fd0/rumpus/README.md

# rumpus

Hard- and Software for the rumpus Atmel AVR development platform.

Helpful links:
 * http://lochraster.org/rumpus
 * http://wiki.lochraster.org/wiki/Rumpus/Aufbauanleitung-v2.html
 * http://wiki.lochraster.org/wiki/Rumpus/Schnellstart.html
