fd0/rumpus/PCB/rumpus.brd

## EAGLE design PCB/rumpus.brd (2016-03-28)

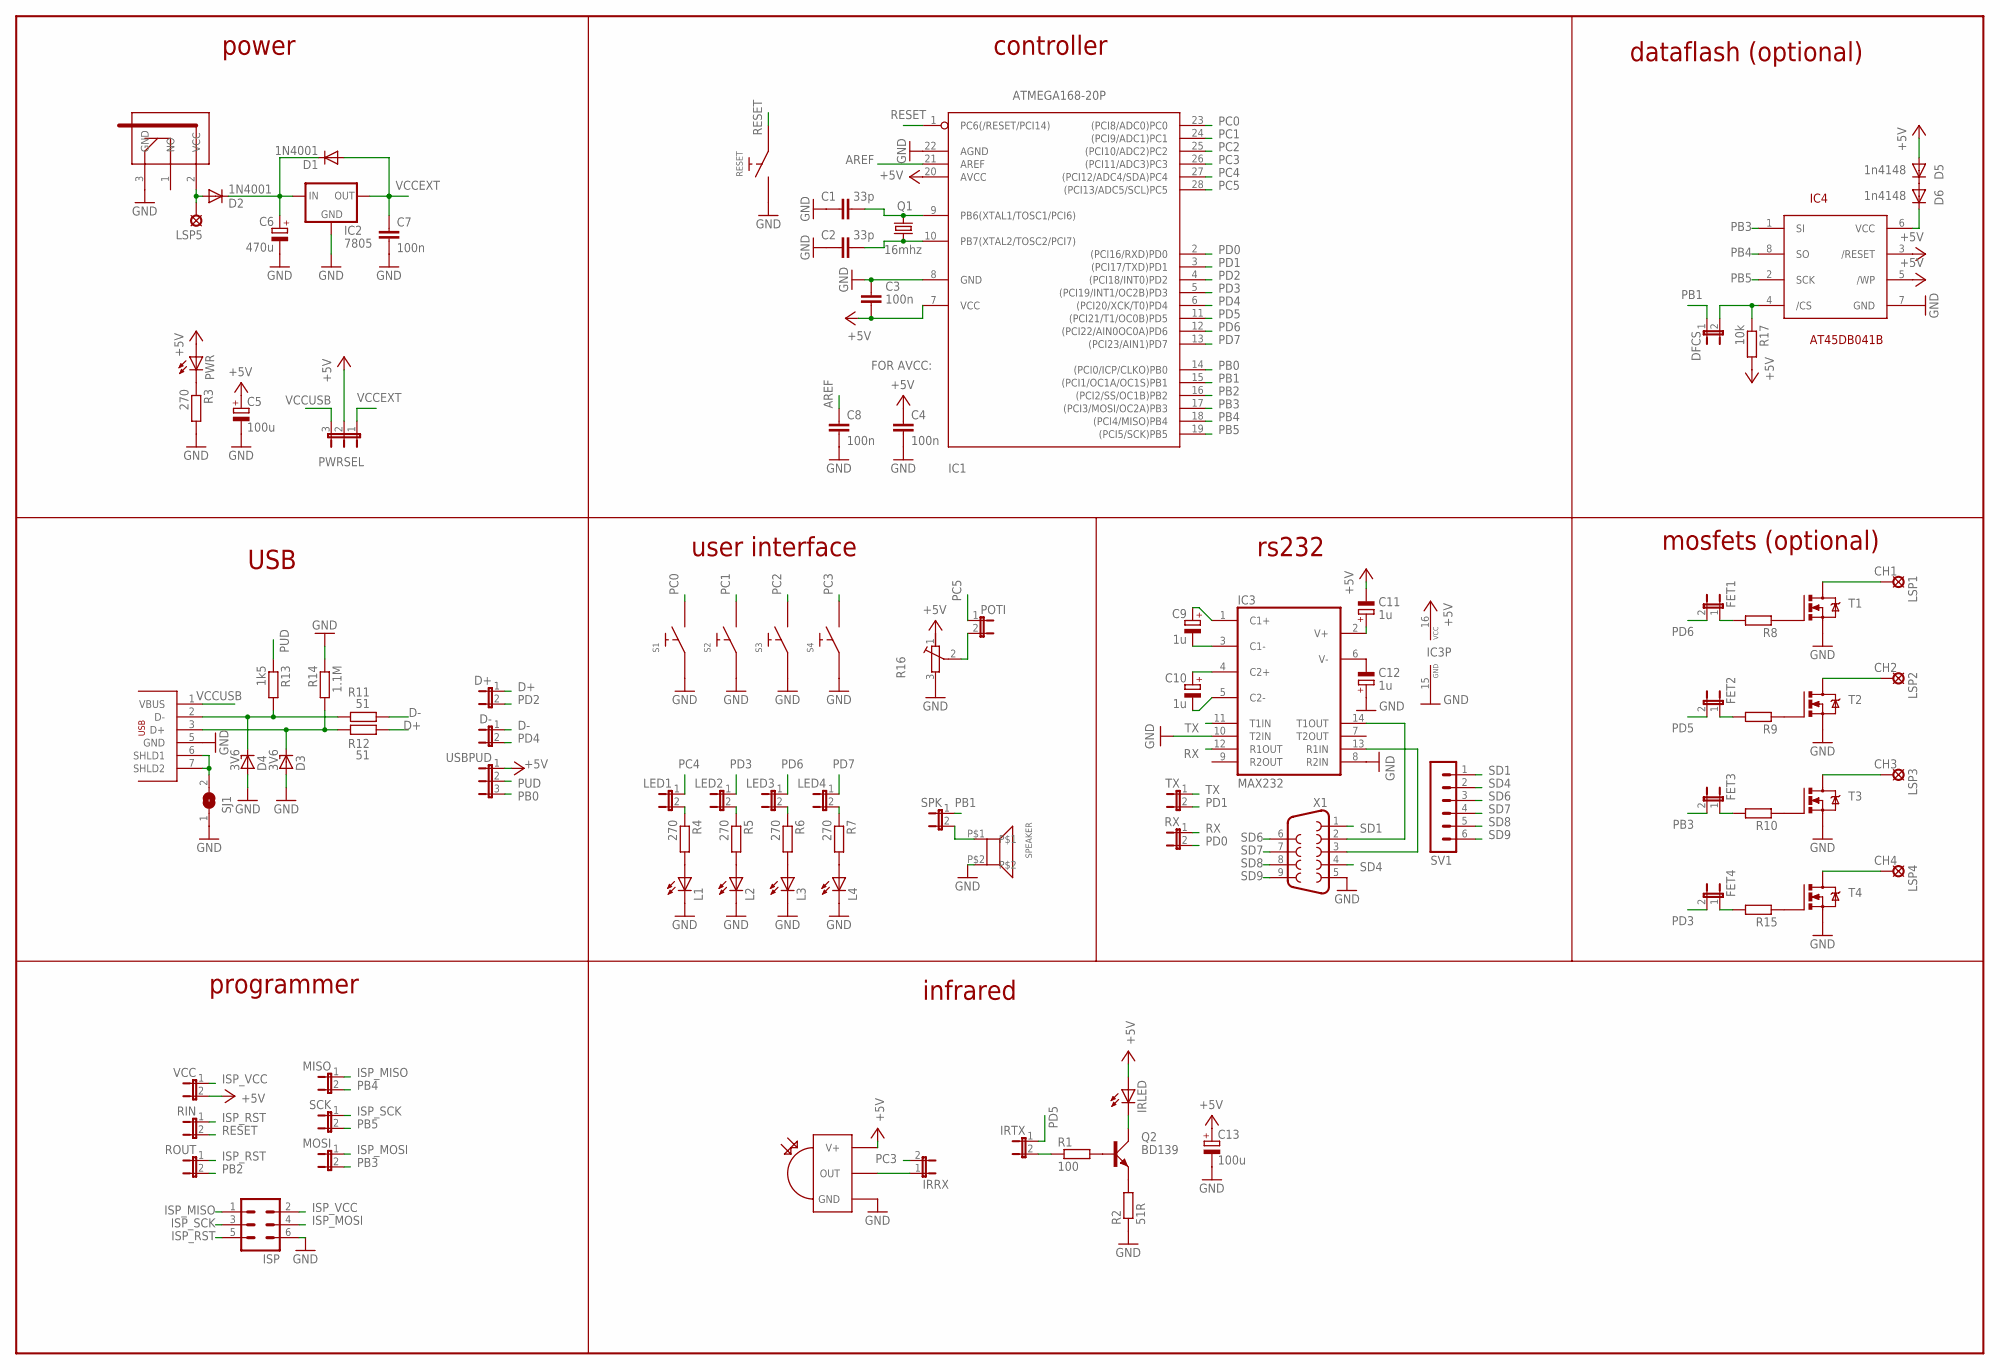
[picture p1: schematic rumpus.sch]

Parts:
C1, C2: 33p; C025-024X044
C3, C4, C7, C8: 100n; C025-024X044
C5, C13: 100u; E2,5-6
C6: 470u; E5-10,5
C9, C10, C11, C12: 1u; E2,5-6
D1, D2: 1N4001; DO41-10
D3, D4: 3V6; ZDIO-2.5
D5, D6: 1n4148; D-2.5
D+: JP1E; JP1
D-: JP1E; JP1
DFCS: JP1E; JP1
FET1, FET2, FET3, FET4: JP1E; JP1
IC1: ATMEGA168-20P; DIL28-3
IC2: 7805; 78XXS
IC3: MAX232; DIL16
IC4: AT45DB041B; SOIC8
IRLED: LED5MM
IRRX: JP1E; JP1
IRTX: JP1E; JP1
ISP: MA03-2
L1, L2, L3, L4: LED3MM
LED1, LED2, LED3, LED4: JP1E; JP1
LSP1, LSP2, LSP3, LSP4, LSP5: LSP10
MISO: JP1E; JP1
MOSI: JP1E; JP1
POTI: JP1E; JP1
PWR: LED3MM
PWRSEL: JP2E; JP2
Q1: 16mhz; HC49U-V
Q2: BD139; TO126AV
R1: 100; 0204V
R2: 51R; 0204V
R3: 270; 0204/7
R4, R5, R6, R7: 270; 0204V
R8, R9, R10, R15: R-EU_0204/2V; 0204V
R11, R12: 51; 0204V
R13: 1k5; 0204V
R14: 1.1M; 0204V
R16: R-TRIMMPT6-L; PT6-L
R17: 10k; 0204V
RESET: MIKROTASTER6X6L; TASTER3301
RIN: JP1E; JP1
ROUT: JP1E; JP1
RX: JP1E; JP1
S1, S2, S3, S4: MIKROTASTER6X6L; TASTER3301
SCK: JP1E; JP1
SJ1: SJ
SPEAKER: BUZZER
SPK: JP1E; JP1
SV1: MA06-1
T1, T2, T3, T4: N-CHANNEL-MOSFET; TO220BV
TX: JP1E; JP1
U$2: TSOP1738; TSOP17XX
U$3: HEBW21
USB: USB-SOCKETMINI-B; USB-BWM
USBPUD: JP2E; JP2
VCC: JP1E; JP1
X1: F09HP

Connections:
+5V: C3.2, C4.1, C5.+, C11.-, C13.+, D5.A, IC1.7 (VCC), IC1.20 (AVCC), IC3.16 (VCC), IC4.3 (/RESET), IC4.5 (/WP), IRLED.A, PWR.A, PWRSEL.2, R16.1 (A), R17.2, U$2.V+, USBPUD.1, VCC.2
AREF: C8.1, IC1.21 (AREF)
CH1: LSP1.MP, T1.D
CH2: LSP2.MP, T2.D
CH3: LSP3.MP, T3.D
CH4: LSP4.MP, T4.D
D+: D+.1, R12.2
D-: D-.1, R11.2
GND: C1.2, C2.2, C3.1, C4.2, C5.-, C6.-, C7.2, C8.2, C12.+, C13.-, D3.A, D4.A, IC1.8 (GND), IC1.22 (AGND), IC2.GND, IC3.8 (R2IN), IC3.10 (T2IN), IC3.15 (GND), IC4.7 (GND), ISP.6, L1.K (C), L2.K (C), L3.K (C), L4.K (C), R2.1, R3.2, R14.1, R16.3 (E), RESET.2, S1.1, S2.1, S3.1, S4.1, SJ1.1, SPEAKER.P$2, T1.S, T2.S, T3.S, T4.S, U$2.GND, U$3.3 (GND), USB.5 (GND), X1.5
IR_OUT: IRTX.2, R1.1
ISP_MISO: ISP.1, MISO.1
ISP_MOSI: ISP.4, MOSI.1
ISP_RST: ISP.5, RIN.1, ROUT.1
ISP_SCK: ISP.3, SCK.1
ISP_VCC: ISP.2, VCC.1
unnamed: D2.A, LSP5.MP, U$3.2 (VCC)
unnamed: PWR.K (C), R3.1
unnamed: C1.1, IC1.9 (PB6(XTAL1/TOSC1/PCI6)), Q1.1
unnamed: C6.+, D1.C, D2.C, IC2.IN
unnamed: C2.1, IC1.10 (PB7(XTAL2/TOSC2/PCI7)), Q1.2
unnamed: L1.A, R4.2
unnamed: L2.A, R5.2
unnamed: L3.A, R6.2
unnamed: L4.A, R7.2
unnamed: LED1.2, R4.1
unnamed: LED2.2, R5.1
unnamed: LED3.2, R6.1
unnamed: SJ1.2, USB.6 (SHLD1), USB.7 (SHLD2)
unnamed: D3.C, R12.1, R14.2, USB.3 (D+)
unnamed: D4.C, R11.1, R13.2, USB.2 (D-)
unnamed: LED4.2, R7.1
unnamed: R8.1, T1.G
unnamed: R9.1, T2.G
unnamed: R10.1, T3.G
unnamed: R15.1, T4.G
unnamed: C9.+, IC3.1 (C1+)
unnamed: C9.-, IC3.3 (C1-)
unnamed: C10.+, IC3.4 (C2+)
unnamed: C10.-, IC3.5 (C2-)
unnamed: C11.+, IC3.2 (V+)
unnamed: C12.-, IC3.6 (V-)
unnamed: IC3.13 (R1IN), X1.3
unnamed: IC3.14 (T1OUT), X1.2
unnamed: SPEAKER.P$1, SPK.2
unnamed: IRRX.1, U$2.OUT
unnamed: IRLED.K (C), Q2.C
unnamed: Q2.E, R2.2
unnamed: Q2.B, R1.2
unnamed: FET1.1, R8.2
unnamed: FET2.1, R9.2
unnamed: FET3.1, R10.2
unnamed: FET4.1, R15.2
unnamed: POTI.2, R16.2 (S)
unnamed: D5.C, D6.A
unnamed: D6.C, IC4.6 (VCC)
unnamed: DFCS.2, IC4.4 (/CS), R17.1
PB0: IC1.14 ((PCI0/ICP/CLKO)PB0), USBPUD.3
PB1: DFCS.1, IC1.15 ((PCI1/OC1A/OC1S)PB1), SPK.1
PB2: IC1.16 ((PCI2/SS/OC1B)PB2), ROUT.2
PB3: FET3.2, IC1.17 ((PCI3/MOSI/OC2A)PB3), IC4.1 (SI), MOSI.2
PB4: IC1.18 ((PCI4/MISO)PB4), IC4.8 (SO), MISO.2
PB5: IC1.19 ((PCI5/SCK)PB5), IC4.2 (SCK), SCK.2
PC0: IC1.23 ((PCI8/ADC0)PC0), S1.2
PC1: IC1.24 ((PCI9/ADC1)PC1), S2.2
PC2: IC1.25 ((PCI10/ADC2)PC2), S3.2
PC3: IC1.26 ((PCI11/ADC3)PC3), IRRX.2, S4.2
PC4: IC1.27 ((PCI12/ADC4/SDA)PC4), LED1.1
PC5: IC1.28 ((PCI13/ADC5/SCL)PC5), POTI.1
PD0: IC1.2 ((PCI16/RXD)PD0), RX.2
PD1: IC1.3 ((PCI17/TXD)PD1), TX.2
PD2: D+.2, IC1.4 ((PCI18/INT0)PD2)
PD3: FET4.2, IC1.5 ((PCI19/INT1/OC2B)PD3), LED2.1
PD4: D-.2, IC1.6 ((PCI20/XCK/T0)PD4)
PD5: FET2.2, IC1.11 ((PCI21/T1/OC0B)PD5), IRTX.1
PD6: FET1.2, IC1.12 ((PCI22/AIN0OC0A)PD6), LED3.1
PD7: IC1.13 ((PCI23/AIN1)PD7), LED4.1
PUD: R13.1, USBPUD.2
RESET: IC1.1 (PC6(/RESET/PCI14)), RESET.1, RIN.2
RX: IC3.12 (R1OUT), RX.1
SD1: SV1.1, X1.1
SD4: SV1.2, X1.4
SD6: SV1.3, X1.6
SD7: SV1.4, X1.7
SD8: SV1.5, X1.8
SD9: SV1.6, X1.9
TX: IC3.11 (T1IN), TX.1
VCCEXT: C7.1, D1.A, IC2.OUT, PWRSEL.1
VCCUSB: PWRSEL.3, USB.1 (VBUS)

Notes on the sheet:
FOR AVCC:
power
controller
dataflash (optional)
mosfets (optional)
USB
user interface
rs232
infrared
programmer

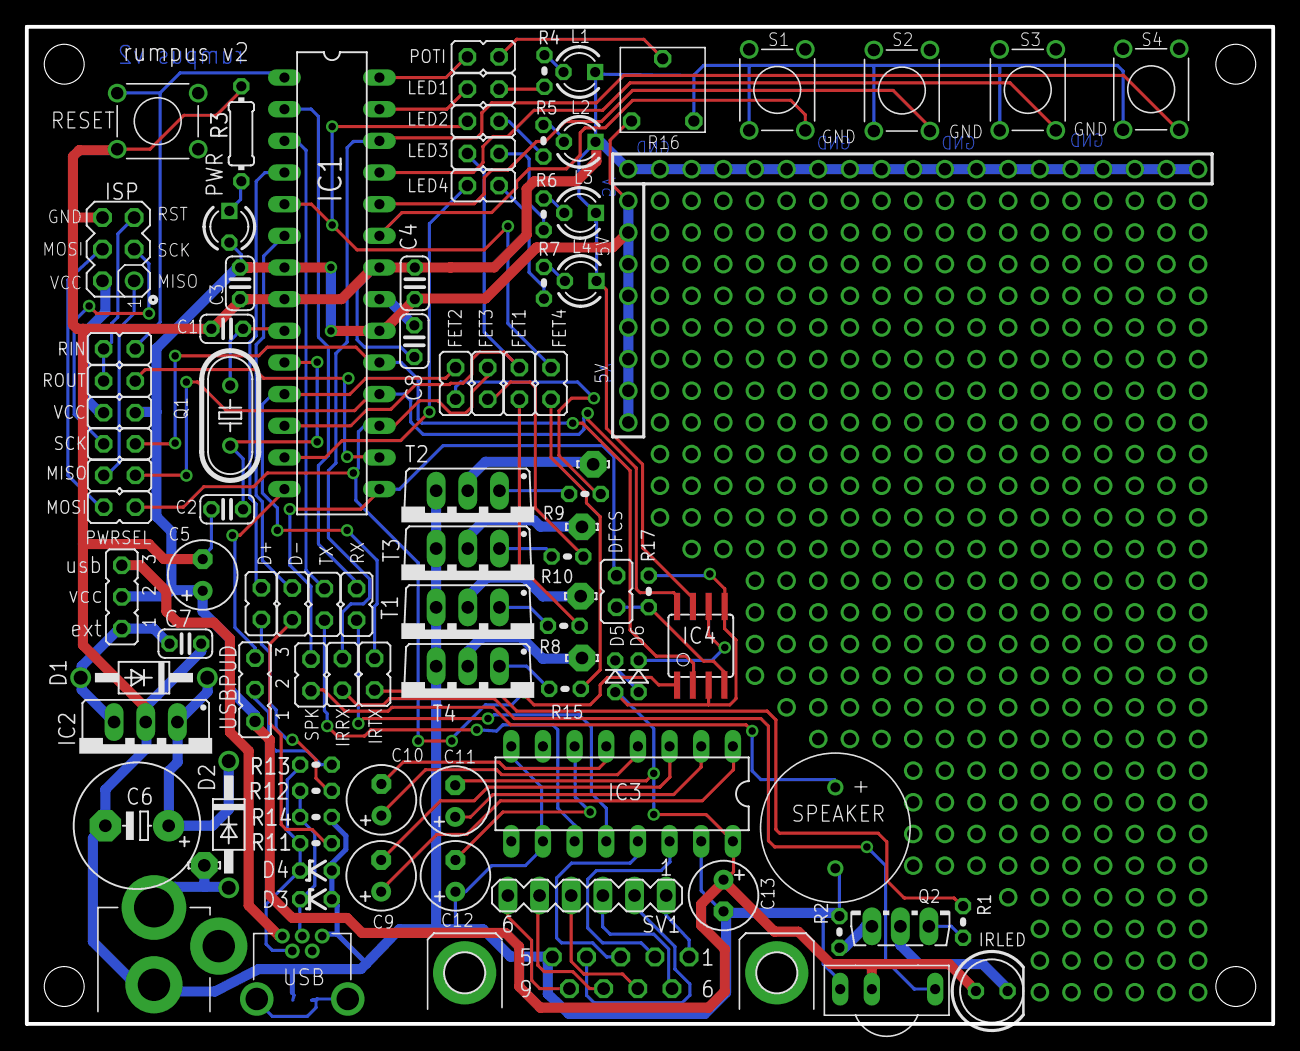
[picture p2: board rumpus.brd from above]

Board: 2 copper layers, 100.0 x 80.0 mm, 95 parts (1 on the bottom side), 88 nets.
