fd0/rumpus/(notices)

Notices in the files:
software/rumpusbasp/usb.c:
This program is free software; you can redistribute it and/or modify
it under the terms of the GNU General Public License version 2 as
published by the Free Software Foundation.
